AthemiS13/scribe/Hardware/charging.png

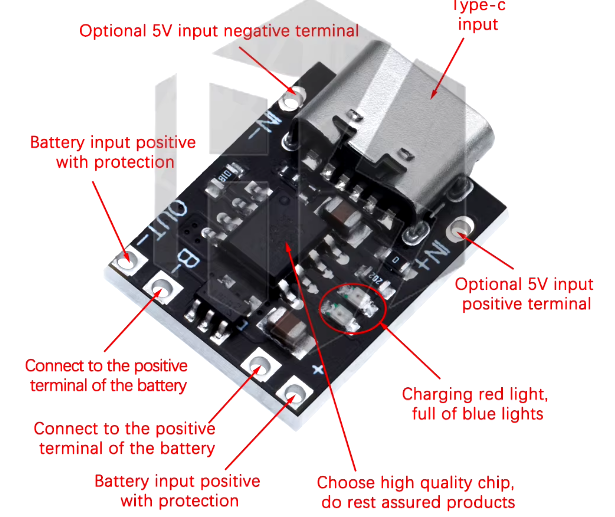
Hardware/charging.png
