AthemiS13/scribe/Hardware/display.png

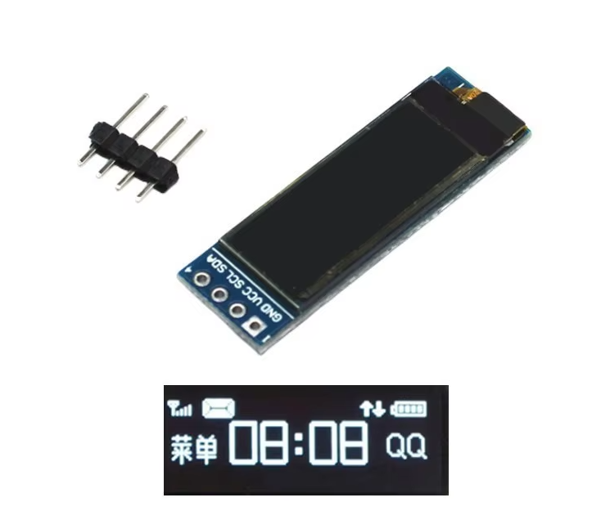
Hardware/display.png
