AthemiS13/scribe/Hardware/esp.png

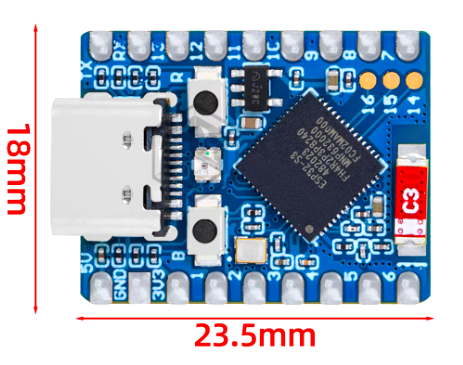
Hardware/esp.png
