AthemiS13/scribe/Hardware/PCB/Manufacturing/scribe-BOM.xlsx

No. | Quantity | Comment | Designator | Footprint | Value | Manufacturer Part | Manufacturer | Supplier Part | Supplier
1 | 2 | 3MMPAD | +,_ | 3MMPAD
2 | 1 | AN3216-245 | ANT | ANT-SMD_L3.2-W1.6-A |  | AN3216-245 | rainsun(霖昱微) | C2916136 | LCSC
3 | 5 | PAD_TERMINAL-32MIL_ROUND | BOOT,CTG,RST,SW,TCH | CON_PAD_ROUND_32MIL
4 | 2 | 4.7uF | C1,C26 | C0805 |  | CL21A475KAQNNNE | SAMSUNG(三星) | C1779 | LCSC
5 | 2 | 10uF | C2,C4 | C0402 |  | CL05A106MQ5NUNC | SAMSUNG(三星) | C15525 | LCSC
6 | 4 | 100nF | C3,C15,C23,C28 | C0603 |  | CC0603KRX7R9BB104 | YAGEO(国巨) | C14663 | LCSC
7 | 1 | 10uF | C5 | C0603 |  | CL10A106KP8NNNC | SAMSUNG(三星) | C19702 | LCSC
8 | 6 | 1uF | C6,C9,C14,C24,C29,C30 | C0402 |  | GRM155R61C105KA12D | muRata(村田) | C77006 | LCSC
9 | 5 | 220nF | C7,C8,C11,C12,C13 | C0402 |  | C0402X7R224K160NT | SANYEAR(叁叶源) | C475248 | LCSC
10 | 1 | 10nF | C10 | C0201 |  | C0603X5R103KDT | DARFON(达方) | C258479 | LCSC
11 | 2 | 8pF | C18,C19 | C0402 |  | 0402CG8R0C500NT | FH(风华) | C1578 | LCSC
12 | 2 | 100nF | C20,C22 | C0402 |  | CL05B104KO5NNNC | SAMSUNG(三星) | C1525 | LCSC
13 | 1 | 2.4pF | C21 | C0402 |  | 0402CG2R4C500NT | FH(风华) | C48346 | LCSC
14 | 2 | 2.2uF | C25,C27 | C0603 |  | C0603C225K8RAC7867 | KEMET(基美) | C599715 | LCSC
15 | 1 | 2.7pF | C31 | C0402 |  | CC0402BRNPO9BN2R7 | YAGEO(国巨) | C326937 | LCSC
16 | 1 | BAT20JFILM | D1 | SOD-323_L1.8-W1.3-LS2.5-RD |  | BAT20JFILM | ST(意法半导体) | C155590 | LCSC
17 | 3 | LESD5D5.0CT1G | D2,D3,D4 | SOD-523_L1.2-W0.8-LS1.6-BI |  | LESD5D5.0CT1G | LRC(乐山无线电) | C383211 | LCSC
18 | 1 | DDZ3V3BSF-7 | D5 | SOD-323F_L1.7-W1.3-LS2.5-RD |  | DDZ3V3BSF-7 | DIODES(美台) | C156333 | LCSC
19 | 1 | 1N4007W | D6 | SOD-123_L2.8-W1.8-LS3.7-RD |  | 1N4007W | BLUE ROCKET | C328592 | LCSC
20 | 1 | ESP32-S3 | ESP | QFN-56_L7.0-W7.0-P0.40-TL-EP4.0 |  | ESP32-S3 | ESPRESSIF(乐鑫) | C2913192 | LCSC
21 | 1 | 2nH | L1 | L0402-RD |  | MLG1005S2N0BTD25 | TDK | C404617 | LCSC
22 | 1 | 24nH | L2 | IND-SMD_L1.2-W0.6 |  | SDWL1005C24NJSTF | Sunlord(顺络) | C370295 | LCSC
23 | 1 | 2.4nH | L3 | L0402 |  | LQG15HS2N4S02D | muRata(村田) | C97997 | LCSC
24 | 1 | N091-2832TSWFG02-H14 | OLED | OLED-SMD_N091-2832TSWFG02-H14 |  | N091-2832TSWFG02-H14 | Newvision(新智景) | C2890599 | LCSC
25 | 1 | VBK3215N | Q1 | SC-70-6_L2.2-W1.3-P0.65-LS2.1-BR |  | VBK3215N | VBsemi(微碧半导体) | C516947 | LCSC
26 | 2 | 5.1kΩ | R1,R2 | R0603 |  | 0603WAF5101T5E | UNI-ROYAL(厚声) | C23186 | LCSC
27 | 1 | 1Ω | R3 | R1206 |  | RT1206BRD071RL | YAGEO(国巨) | C513714 | LCSC
28 | 1 | 2kΩ | R4 | RES-SMD_L3.5-W1.5 |  | RJM74P0204F2T2001 | Tyohm(幸亚电阻) | C410713 | LCSC
29 | 1 | 7.5kΩ | R5 | R1206 |  | RT1206BRD077K5L | YAGEO(国巨) | C870892 | LCSC
30 | 1 | 10kΩ | R6 | R1206 |  | RT1206BRD0710KL | YAGEO(国巨) | C136889 | LCSC
31 | 1 | 100Ω | R7 | R1206 |  | RT1206BRD07100RL | YAGEO(国巨) | C728670 | LCSC
32 | 1 | 1kΩ | R8 | R1206 |  | RT1206BRD071KL | YAGEO(国巨) | C706405 | LCSC
33 | 1 | 1MΩ | R9 | R0603 |  | ERJP03J105V | PANASONIC(松下) | C427290 | LCSC
34 | 4 | 10kΩ | R10,R11,R12,R13 | R0603 |  | 0603WAF1002T5E | UNI-ROYAL(厚声) | C25804 | LCSC
35 | 3 | 4.7kΩ | R14,R15,R16 | R0603 |  | ARG03BTC4701 | Viking(光颉) | C309085 | LCSC
36 | 1 | 560kΩ | R17 | R1206 |  | RC1206FR-07560KL | YAGEO(国巨) | C137254 | LCSC
37 | 1 | MK-11C04-G013 | SW1 | SW-SMD_MK-11C04-G013 |  | MK-11C04-G013 | G-Switch(品赞) | C778185 | LCSC
38 | 1 | TS-1088-AR02016 | SYS | SW-SMD_L3.9-W3.0-P4.45 |  | TS-1088-AR02016 | XUNPU(讯普) | C720477 | LCSC
39 | 1 | TP4056_C382139 | U1 | ESOP-8_L4.9-W3.9-P1.27-LS6.0-BL-EP |  | TP4056 | TPOWER(天源) | C382139 | LCSC
40 | 1 | DW01A_C2927799 | U2 | SOT-23-6_L2.9-W1.6-P0.95-LS2.8-BL |  | DW01A | YONGYUTAI(永裕泰) | C2927799 | LCSC
41 | 1 | AMS1117-3.3_C347222 | U3 | SOT-223-4_L6.5-W3.5-P2.30-LS7.0-BR |  | AMS1117-3.3 | UMW(友台半导体) | C347222 | LCSC
42 | 1 | GD25Q128ESIGR | U4 | SOP-8_L5.3-W5.3-P1.27-LS8.0-BL |  | GD25Q128ESIGR | GigaDevice(兆易创新) | C2928891 | LCSC
43 | 1 | MC-311D | USBC | USB-C-SMD_MC-311D |  | MC-311D | SOFNG(硕方) | C136423 | LCSC
44 | 1 | 40MHz | X1 | CRYSTAL-SMD_4P-L2.5-W2.0-BL |  | K2C400000910 | KYX(凯越翔) | C409424 | LCSC
