AthemiS13/scribe/Hardware/Guide.pdf

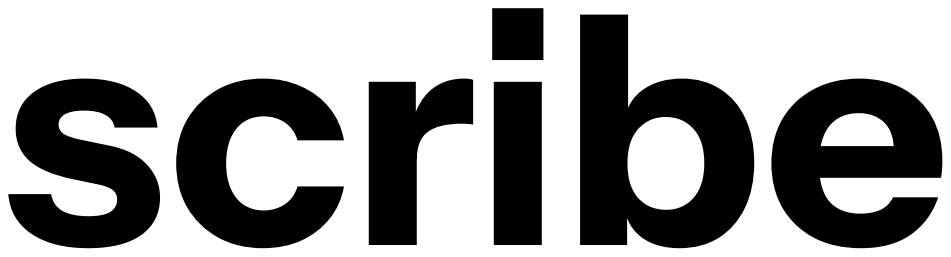
[picture p10: figure]
scribe

This document is a guide to assist you in manually cutting and preparing the necessary components for the scribe project. It provides one-to-one scale templates for precise fitment, ensuring each part is tailored perfectly. Included are

A scaled rectangle for trimming the glass tube to the correct size
A guide for shortening the pen's cartridge to fit the design
Measurements for the tinted foil wrap, calculated for seamless application.

Simply align the physical parts with the printed templates, follow the cutting lines, and you’ll have components ready for assembly.

## Tube Length Tinted Surface

## Cartridge Length

31 mm | 113 mm | 113 mm
