AthemiS13/scribe/Hardware/PCB/scribe-schematic.pdf

### POWER

### DISPLAY

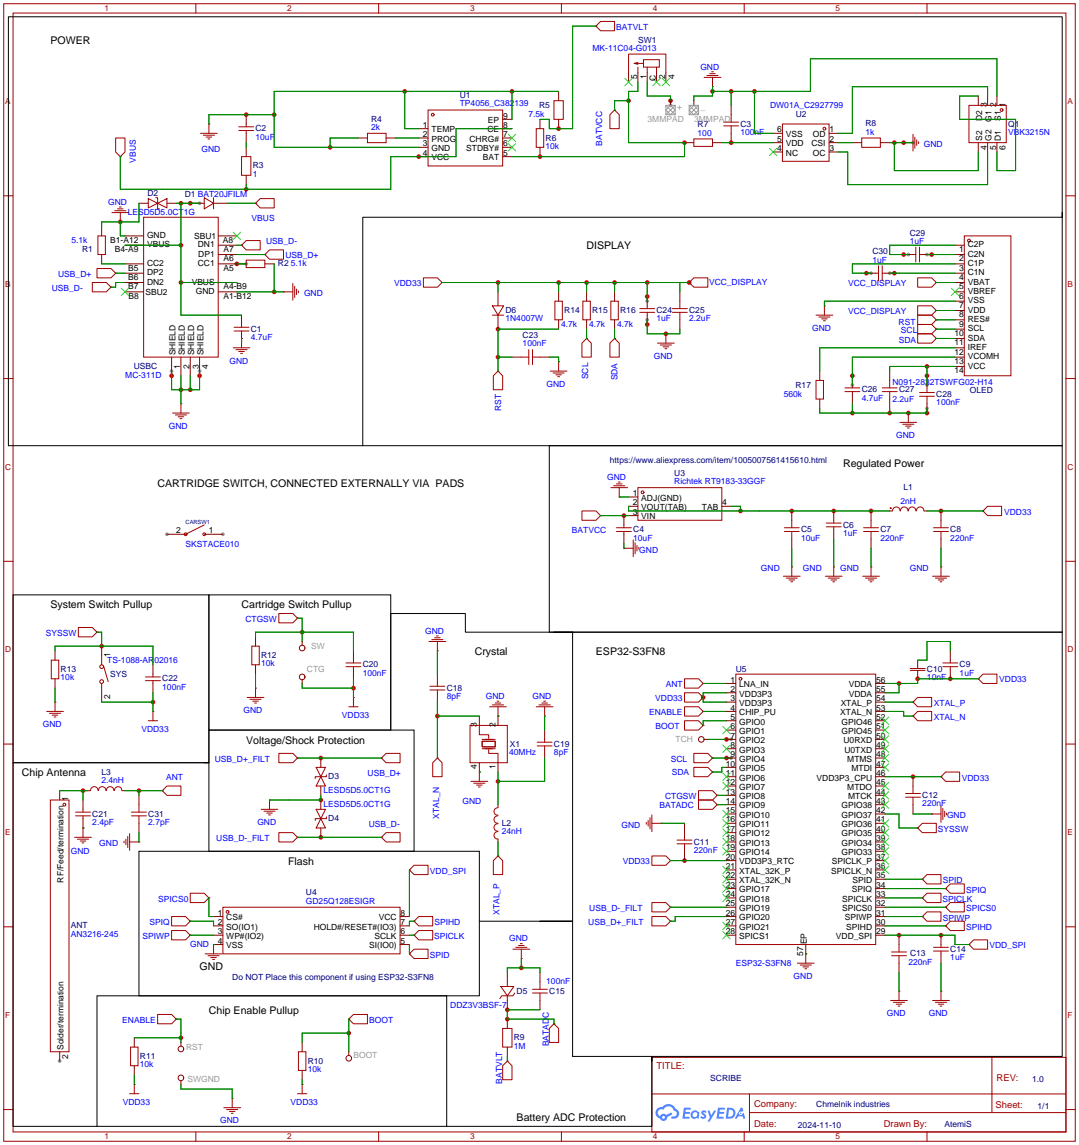
[picture p11: page 1]

CARTRIDGE SWITCH, CONNECTED EXTERNALLY VIA PADS

ANT Chip Antenna RF/Feed/termination
