AthemiS13/scribe/(list of files, drawings)

Other design files:
Hardware/PCB/EasyEDA/scribe.epro
