AthemiS13/scribe/(commit log)

2024-11-30 PBB README.md
    PCB ADDED
2024-11-30 Update README.md
    All images added pcb
2024-12-20 setup arduino
2025-02-08 PCB files added
    [scribe-BOM.xlsx, scribe-pick-and-place.xlsx, scribe.epro]
2025-02-09 Button test added
2025-02-09 button logic added scribe.ino
2025-04-03 fix: right amount of characters per page
    [main.ino]
2025-05-28 fix: handling write without response
    [main.ino]
2025-08-23 fix: disconnect after long press gesture
    [main.ino]
2025-12-27 Update README to include smartphone compatibility, additional PCB images, and Arduino setup instructions
2026-08-15 Add Scribe image to README
    Added an image of the Scribe device to the README.
